codingSkeleton6478/stm32-motor-ecu/README.md

# stm32-motor-ecu

**STM32 두 개를 CAN으로 묶어, 한 보드가 보낸 목표 속도로 다른 보드가 모터를 돌리는 프로젝트입니다.**
엔코더로 속도를 재서 목표 속도를 유지하는 PI 제어, 두 보드 사이의 CAN 통신(체크섬과 alive counter로 메시지 오류를 검사하는 E2E 보호), 통신이 끊기거나 모터가 걸렸을 때 모터를 스스로 멈추는 기능을 직접 만들고, 일부러 고장을 내는 시험 7건으로 확인했습니다.

> **0 → 35 rpm 0.13 s 상승 · 오버슈트 0.9%** · **CAN 500 kbps, 0x200 프레임 208개 누락 0** · **통신 끊김 107 ms 만에 안전 정지** · **고장 주입 시험 7건 모두 통과**

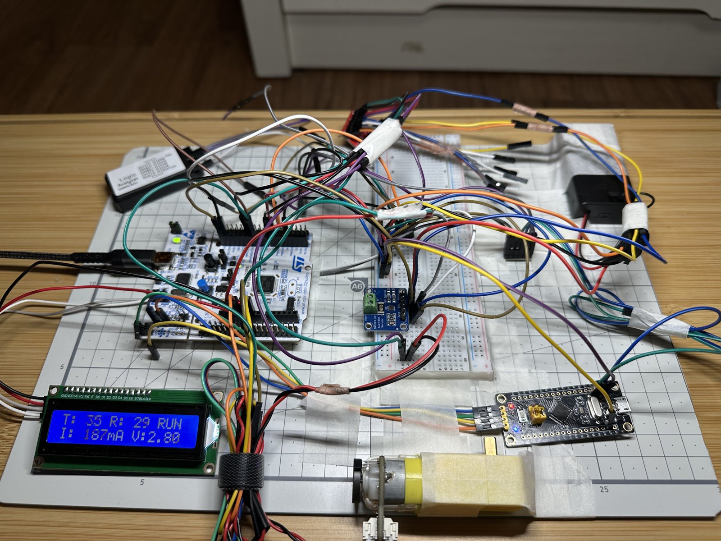
[picture p1: docs/images/hardware_setup.jpg]
실제 하드웨어 구성


*실제 동작 중인 하드웨어입니다. 왼쪽 NUCLEO-F103RB(모터 ECU), 오른쪽 아래 STM32F103C8T6 소형 보드(명령 ECU), 가운데 INA219 전류 센서, 아래 엔코더 기어드 모터, 왼쪽 아래 LCD에 목표 35 rpm · RUN 상태 · 전류 187 mA가 표시되고 있습니다.*

## 시스템 구성도

시스템 구성도

*draw.io로 그린 구성도입니다. 검은 화살표는 신호, 빨간 선은 모터 전원 경로, 굵은 선은 CAN 버스입니다. `docs/images/system_diagram.drawio.svg` 파일을 draw.io에서 열면 바로 수정할 수 있습니다.*

## 프로젝트 목적

STM32로 **모터를 직접 돌려 보고, 두 보드끼리 CAN 통신을 해 보는 것**을 배우고 싶어서 시작한 프로젝트입니다. 예제 코드를 그대로 돌리는 데서 끝내지 않고, 부품을 직접 고르고 배선하고, 실제로 잘 동작하는지 로직 분석기로 재 보는 것까지 해 보는 것을 목표로 했습니다.

이 프로젝트로 배우고 싶었던 것은 다음 세 가지입니다.

1. **모터 제어:** PWM으로 모터 속도를 바꾸고, 엔코더로 실제 속도를 읽어서 원하는 속도를 유지하도록(PI 제어) 만드는 방법
2. **CAN 통신:** 한 보드가 목표 속도를 보내고, 다른 보드가 받아서 모터를 돌린 뒤 현재 상태를 다시 보내는 2노드 통신
3. **문제 상황 대응:** 통신이 끊기거나 모터가 걸려 멈추는 상황을 알아채고 모터를 안전하게 세우는 방법

이 목적에 맞춰 아래 부품을 구매했습니다.

| 목적 | 부품 | 용도 |
|---|---|---|
| 모터 제어 보드 | NUCLEO-F103RB | 디버거가 내장돼 있어 바로 개발하고 디버깅할 수 있습니다 |
| 명령 보드 | STM32F103C8T6 소형 보드 | CAN 통신 상대가 될 두 번째 보드입니다 |
| CAN 통신 | SN65HVD230 트랜시버 × 2 | STM32의 CAN 신호를 실제 CAN 버스 신호로 바꿔 줍니다 |
| 모터 구동 | TB6612FNG 모터 드라이버 | MCU 신호로 모터에 큰 전류를 흘려 줍니다 |
| 모터 | FIT0450 엔코더 기어드 모터 | 엔코더가 달려 있어 실제 속도를 잴 수 있습니다 |
| 전류 측정 | INA219 전류 센서 | 모터가 걸렸을 때(과전류) 알아채는 데 씁니다 |
| 표시 | 1602 I2C LCD | 목표 속도, 실제 속도, 상태를 PC 없이 보여 줍니다 |
| 속도 입력 | 가변저항 모듈 | 손으로 목표 속도를 넣으려고 샀으나 파손되어 쓰지 못했습니다 |
| 측정 | USB 로직 분석기 | PWM, CAN 신호, 반응 시간을 직접 재 봅니다 |

### 왜 보드 두 개를 CAN으로 나눴나요

보드 한 개로도 모터는 돌릴 수 있습니다. 그래도 일부러 **명령하는 보드**와 **모터를 돌리는 보드**를 나누고 CAN으로 연결했습니다. 실제 자동차가 이렇게 동작하기 때문입니다. 자동차에서는 운전자의 페달 입력을 읽는 제어기와 실제로 모터나 엔진을 돌리는 제어기가 따로 있고, 둘이 CAN 버스로 명령과 상태를 주고받습니다.

이 구조를 작게 따라 하기 위해 역할을 이렇게 나눴습니다.

| 보드 | 역할 | 보내는 메시지 |
|---|---|---|
| 소형 보드 (명령 보드) | 사용자 대신 목표 속도를 정해서 보냅니다. 지금은 0 → 20 → 35 → 20 rpm 순서를 자동으로 반복합니다 | 0x100 목표 속도 (10 ms마다) |
| NUCLEO (모터 제어 보드) | 받은 목표 속도에 맞춰 엔코더와 PI 제어로 모터를 돌립니다 | 0x200 실제 속도 · 전류 · 상태 (20 ms마다) |

원래는 소형 보드에 가변저항을 달아, 자동차 가속 페달처럼 손잡이를 돌리면 CAN 너머의 모터 속도가 따라 올라가게 만들 계획이었습니다. 진행 중에 가변저항 모듈이 파손되어, 대신 정해진 속도 순서를 자동으로 보내는 방식으로 완성했습니다. 이 방식은 시험할 때마다 같은 조건을 만들 수 있어 측정을 비교하기에는 오히려 편했습니다.

보드를 나누면 한 보드에서는 생기지 않는 문제가 생깁니다. **통신선이 끊기거나 메시지가 깨지면 모터 제어 보드는 어떻게 해야 할까?** 하는 문제입니다. 명령이 끊겼는데 모터가 마지막 속도로 계속 돌면 위험하기 때문에, 모터 제어 보드는 정상 메시지가 100 ms 동안 오지 않으면 스스로 모터를 멈추게 했습니다. 실제로 CANH 선을 뽑아 시험했을 때 약 107 ms 만에 모터가 멈췄습니다.

또 메시지마다 **alive counter(순번 0~15)와 체크섬**을 넣어서(E2E 보호), 같은 메시지가 반복되거나 내용이 깨진 경우도 알아챌 수 있게 했습니다.

## 보드 구성

모든 수치는 직접 측정한 값입니다(근거: [`docs/measurements.md`](docs/measurements.md), [`docs/test_report.md`](docs/test_report.md)).

| 노드 | 보드 | 역할 |
|---|---|---|
| 모터 ECU | NUCLEO-F103RB | 엔코더 PI 속도 제어, 전류 감시, 고장 판단·안전 상태, IWDG |
| 명령 ECU | STM32F103C8T6 소형 보드 | 목표 속도 명령(0x100) 송신, 상태(0x200) 수신·LED 표시 |

## 핀 맵 (NUCLEO-F103RB)

| 기능 | MCU 핀 | 연결 |
|---|---|---|
| 모터 PWM 20 kHz | PA6 (TIM3_CH1) | TB6612 PWMA |
| 모터 방향 | PA8 / PA9 | TB6612 AIN1 / AIN2 |
| 드라이버 enable (안전 차단) | PB5 | TB6612 STBY |
| 엔코더 A / B (5 V, FT 핀) | PB6 / PB7 (TIM4 엔코더 모드) | FIT0450 엔코더 |
| I2C SCL / SDA (FT 핀) | PB8 / PB9 (I2C1 리맵) | INA219, LCD(PCF8574) |
| CAN RX / TX | PA11 / PA12 | SN65HVD230 CRX / CTX |
| 디버그 타이밍 | PB0 | 로직 분석기 |
| UART | PA2 / PA3 (USART2), PB10 (USART3 미러) | PC 로그 |

## CAN 메시지

| ID | 방향 | 주기 | 내용 |
|---|---|---|---|
| 0x100 CMD | 명령 ECU → 모터 ECU | 10 ms | B0–1 목표 rpm (uint16 LE) · B2 alive counter(순번) 0~15 · B3 체크섬 = (B0 ^ B1 ^ B2) ^ 0xFF |
| 0x200 STATUS | 모터 ECU → 명령 ECU | 20 ms | B0–1 실제 rpm (int16) · B2–3 전류 mA · B4 상태(0 STOP, 1 RUN, 2 FAULT) · B5 고장 코드 비트 |

비트 타이밍은 500 kbps, 샘플 포인트 87.5%(Nucleo) / 88.9%(소형 보드)입니다. 0x200 주기는 실측 19.99~20.20 ms이고, 4.15 s 동안 208개 중 누락은 0개였습니다.

## 속도 제어 결과 (SR-01)

PI(Kp 50, Ki 300, 10 ms 주기, 조건부 적분 anti-windup), 0 → 35 rpm 스텝, 무부하, AA×2 조건입니다.

| 상승시간(10→90%) | 오버슈트 | 정상상태 오차 | ±2% 정착 | 제어 ISR 실행 시간 |
|---|---|---|---|---|
| 0.13 s | 0.3 rpm (0.9%) | ±0.2 rpm | 0.62 s | 약 24 µs (10 ms 중 0.24%) |

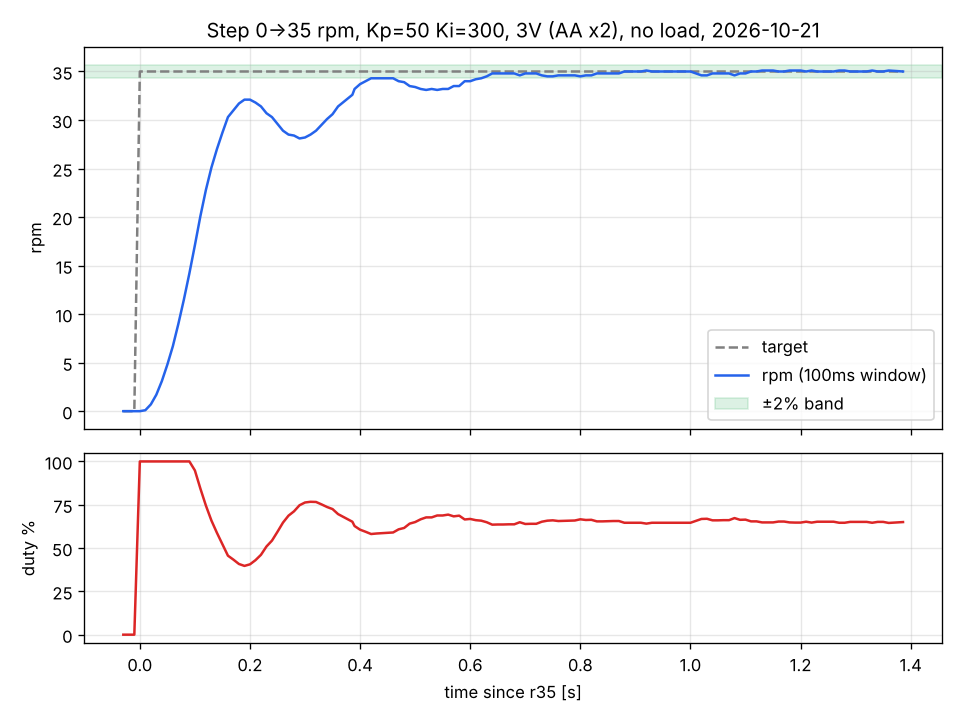
[picture p2: docs/captures/day06_step_kp50_ki300.png]
스텝 응답


제어 루프를 TIM2 ISR에서 돌리는 이유를 실험으로 확인했습니다. LCD I2C 블로킹 중 main loop에서 실행하면 제어 주기가 28.6 ms(가끔 57.3 ms)로 늘어나 rpm이 22.5~45.6으로 진동했고, ISR에서 실행하면 주기 10.026~10.029 ms로 35 rpm을 유지했습니다.

## 고장 감지와 안전 상태

| 요구사항 | 감지 조건 | 동작 |
|---|---|---|
| SR-02 | 유효 0x100이 100 ms 없음 | STBY Low + 듀티 0, 고장 코드 래치 |
| SR-03 | 체크섬·alive 오류 3회 연속 | 〃 |
| SR-04 | 전류 > 380 mA가 200 ms 지속 | 〃 |
| SR-05 | 듀티 > 40%인데 300 ms 동안 카운트 변화 < 10 | 〃 |
| SR-06 | main loop 멈춤 (IWDG 약 100 ms) | 칩 리셋, 부팅 시 원인 출력 |
| SR-07 | (복귀 조건) 감지 중인 고장 없음 + 목표 0 | FAULT → STOP |
| SR-08 | INA219 읽기 실패 200 ms 지속 | STBY Low + 듀티 0 |

상세 내용은 [`docs/requirements.md`](docs/requirements.md)에 있습니다.

## 고장 주입 시험 결과

| ID | 주입 | 결과 |
|---|---|---|
| FI-01 | CANH 선 분리 | 107.3 ms에 정지 |
| FI-02 | 명령 ECU 리셋 | 104.7 ms에 정지 |
| FI-03 | 체크섬 오염 | 첫 오염 프레임 후 28.6 ms에 정지 |
| FI-04 | 바퀴를 잡아 스톨 | 과전류로 약 200 ms에 정지 |
| FI-05 | 엔코더 전원 분리 | 약 570 ms에 정지 |
| FI-06 | main 무한 루프 | 워치독 리셋, `reset by watchdog` 출력 |
| FI-07 | 고장 중 통신 복구 | 목표 0 전까지 재가동 안 함 |

측정은 로직 분석기 12 MHz로 CAN(CRX)과 STBY를 동시에 캡처해, 마지막 유효 프레임부터 STBY 하강까지의 간격을 쟀습니다. 상세 내용과 시험 중 발견한 문제(과전류 임계값 600 → 380 mA 재설정 등)는 [`docs/test_report.md`](docs/test_report.md)에 있습니다.

## 신호 캡처

| 대상 | 파일 |
|---|---|
| CAN 루프백 (0x123) | [`docs/captures/day08_can_loopback.png`](docs/captures/day08_can_loopback.png) |
| CAN 2노드 0x100 디코딩 | [`docs/captures/day09_can_0x100.png`](docs/captures/day09_can_0x100.png) |
| CAN 2노드 0x100/0x200 | [`docs/captures/day09_can_2node.png`](docs/captures/day09_can_2node.png) |
| 고장 주입 원본 (CAN 주석 + VCD) | `docs/captures/day10_fi0*.txt`, `.vcd` |

## 알려진 한계

- 모터 전원이 AA×2(약 3 V)라 사양(6 V)보다 낮습니다. 최고 속도는 약 58 rpm, 스톨 전류는 약 430 mA입니다. 전원을 바꾸면 과전류 기준값을 다시 정해야 합니다.
- 엔코더 고장 감지는 300 ms 고정 구간으로 판단해서 최대 약 600 ms가 걸립니다(구간을 겹쳐 가며 보는 방식으로 줄일 수 있습니다).
- 과전류 기준값과 스톨 전류의 차이가 약 50 mA로 작습니다.
- CAN 선이 끊긴 동안에는 모터 제어 보드가 고장 상태를 명령 보드에 알릴 수 없습니다.
- 워치독 리셋 시간과 전류 센서 읽기 실패 감지(SR-08)는 정밀하게 시험하지 않았습니다.
- 가변저항 모듈이 파손되어 손으로 목표 속도를 바꾸는 입력은 없습니다. 목표 속도는 명령 보드의 자동 순서로만 정해집니다.

## 저장소 구조

```
stm32-motor-ecu/
├── nucleo_motor_ecu/     # 모터 ECU (CubeMX + CMake)
├── bluepill_cmd_ecu/     # 명령 ECU (CubeMX + CMake)
└── docs/
    ├── measurements.md   # 측정값 (모든 수치의 근거)
    ├── requirements.md   # 안전 요구사항 SR-01~08
    ├── test_report.md    # 고장 주입 시험 FI-01~07
    ├── images/           # 하드웨어 사진, 시스템 구성도(draw.io)
    └── captures/         # 로직 분석기 캡처, 그래프
```

## 개발 환경

STM32CubeMX, VS Code + CMake(arm-none-eabi-gcc), STM32CubeProgrammer CLI, PulseView(sigrok), C(HAL)을 사용했습니다.
