codingSkeleton6478/stm32-motor-ecu/docs/requirements.md

# 안전 요구사항 (SR) 과 검증 추적표

모터 ECU(NUCLEO-F103RB)의 안전 관련 요구사항이다. 각 요구사항은 코드 주석(`/* SR-xx */`)과 시험 ID(FI-xx)로 추적된다.
수치는 `docs/measurements.md`의 실측값만 사용한다.

## 1. 요구사항

| ID | 요구사항 | 근거 (설계 값을 정한 이유) | 구현 위치 | 검증 |
|---|---|---|---|---|
| SR-01 | 모터 ECU는 목표 RPM을 정상상태 오차 ±1 rpm 안에서 추종해야 한다. | Day 6 스텝 응답 실측 ±0.2 rpm에 여유를 둠 | `ctrl.c`, `pi.c` (TIM2 10 ms ISR) | Day 6 스텝 응답 0→35 rpm |
| SR-02 | 유효한 CMD(0x100) 프레임을 100 ms 동안 받지 못하면 110 ms 이내에 모터 출력을 차단(STBY Low, 듀티 0)해야 한다. | CMD 주기 10 ms의 10배. 판정이 10 ms 주기라 최대 지연 = 100 + 10 ms | `fault.c` `fault_step_10ms()` | FI-01, FI-02 |
| SR-03 | 체크섬 또는 alive counter가 틀린 프레임은 버리고, 3회 연속이면 FAULT로 전환해야 한다. | 단발 노이즈에는 반응하지 않고, 송신 측 고장은 약 30 ms 안에 잡음 | `can_if.c` 수신 콜백, `fault.c` | FI-03 |
| SR-04 | 모터 전류가 380 mA를 넘는 상태가 200 ms 지속되면 모터 출력을 차단해야 한다. | 정상 최대 315 mA(Day 7 손 부하)와 스톨 425~435 mA(Day 10, AA×2) 사이. 출발 순간 피크(최대 403 mA, 1샘플)는 200 ms 지속 조건으로 거름 | `fault.c` `check_current()` | FI-04 |
| SR-05 | 듀티가 40%를 넘는데 300 ms 동안 엔코더 카운트 변화가 10 미만이면 모터 출력을 차단해야 한다. | 듀티 40%에서 정상 회전은 300 ms에 약 400 카운트(Day 5 듀티-RPM 표, CPR 3840) | `fault.c` `check_encoder()` | FI-05 |
| SR-06 | 소프트웨어가 멈추면 워치독(IWDG)이 약 100 ms 안에 리셋해야 하고, 부팅 시 리셋 원인을 출력해야 한다. | LSI 40 kHz / 32 × 125 ≈ 100 ms (LSI 30~60 kHz 범위에서 67~133 ms). main loop 최장 블로킹(LCD 약 20 ms)보다 충분히 김 | `main.c` (refresh는 main loop에서만) | FI-06 |
| SR-07 | 고장 후에는 자동 재가동을 금지하고, 감지 중인 고장이 없고 목표가 0인 것을 확인한 뒤에만 STOP으로 복귀해야 한다. | 통신 복구 순간 마지막 목표로 갑자기 도는 것을 막음 | `fault.c` | FI-07 (FI-02, FI-04, FI-05에서도 관찰) |
| SR-08 | 전류 센서(INA219) 읽기 실패가 200 ms 지속되면 모터 출력을 차단해야 한다. | Day 7: I2C 실패 중 변수에 옛 값이 남아 정상처럼 보임 → 과전류 감시 불가 상태를 고장으로 봄 | `fault.c` `check_current()` | 미시험 (FI-08 예정) |

## 2. 고장 코드 (0x200 B5, 비트별)

| 비트 | 값 | 고장 | 요구사항 |
|---|---|---|---|
| 0 | 0x01 | CAN 타임아웃 | SR-02 |
| 1 | 0x02 | CAN E2E(체크섬·alive) 3회 연속 | SR-03 |
| 2 | 0x04 | 과전류 | SR-04 |
| 3 | 0x08 | 엔코더 고장 | SR-05 |
| 4 | 0x10 | 전류 센서 무효 | SR-08 |

고장 코드는 래치되며, SR-07 복귀 조건을 만족하면 0으로 지워진다.

## 3. 추적표 (요구사항 ↔ 시험)

| 요구사항 | FI-01 | FI-02 | FI-03 | FI-04 | FI-05 | FI-06 | FI-07 |
|---|---|---|---|---|---|---|---|
| SR-02 | ● | ● | ○ | | | | |
| SR-03 | | | ● | | | | |
| SR-04 | | | | ● | | | |
| SR-05 | | | | ○ | ● | | |
| SR-06 | | | | | | ● | |
| SR-07 | | ○ | | ○ | ○ | | ● |

● 주 검증, ○ 부수적으로 관찰
