codingSkeleton6478/stm32-motor-ecu/docs/captures/day08_can_loopback.png

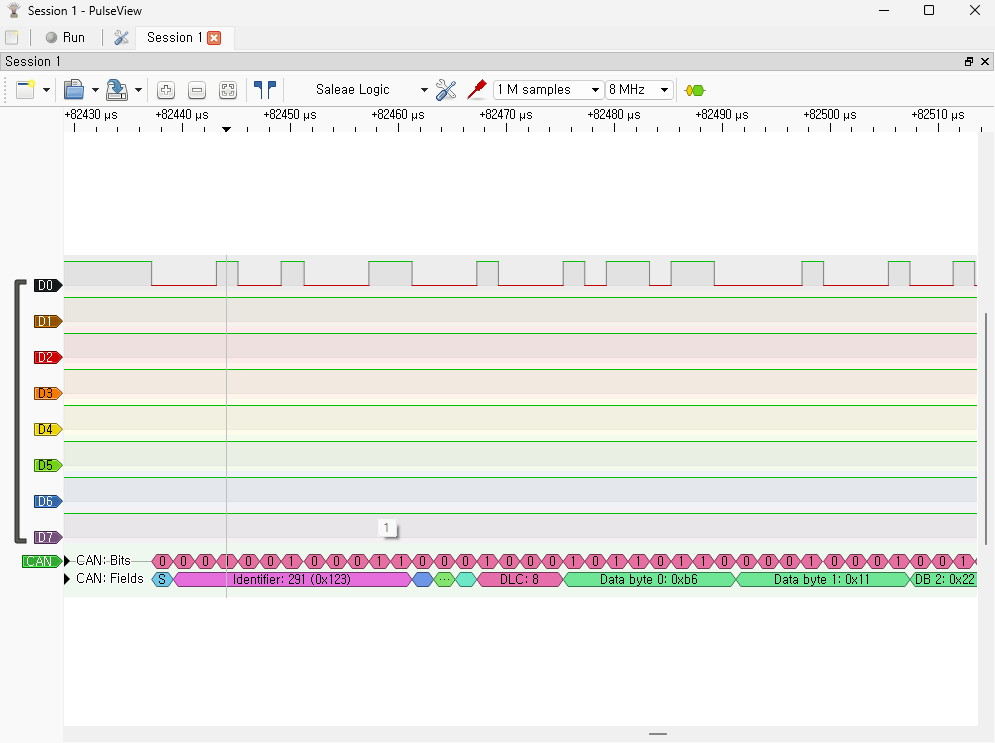
docs/captures/day08_can_loopback.png
