codingSkeleton6478/stm32-motor-ecu/docs/captures/day09_can_0x100.png

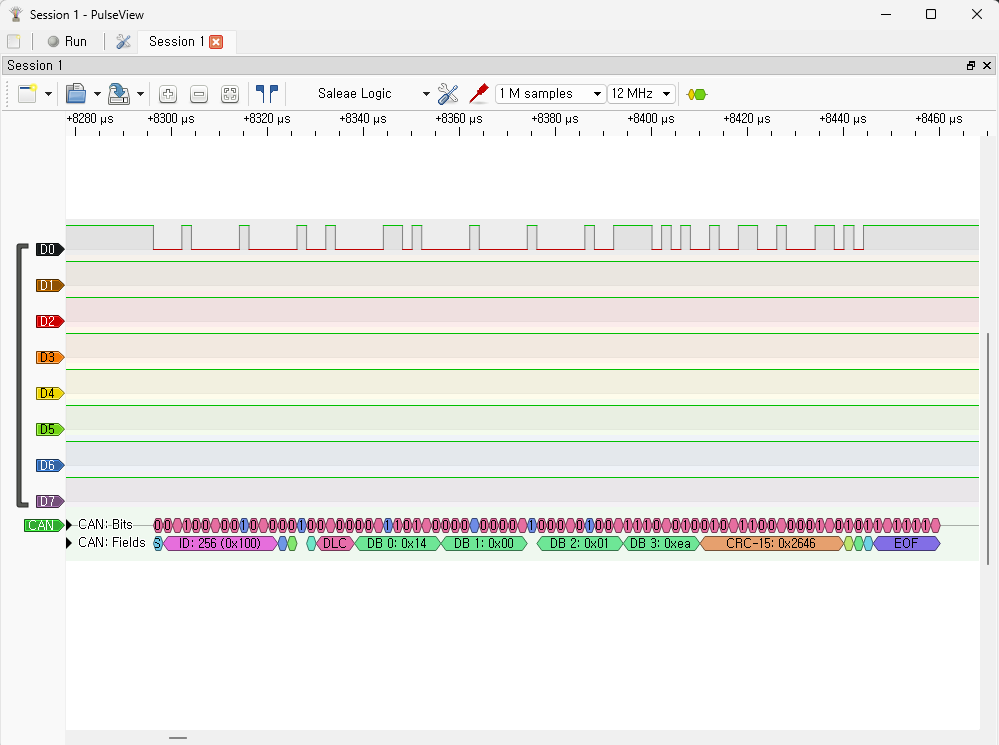
docs/captures/day09_can_0x100.png
