codingSkeleton6478/stm32-motor-ecu/docs/captures/day09_can_2node.png

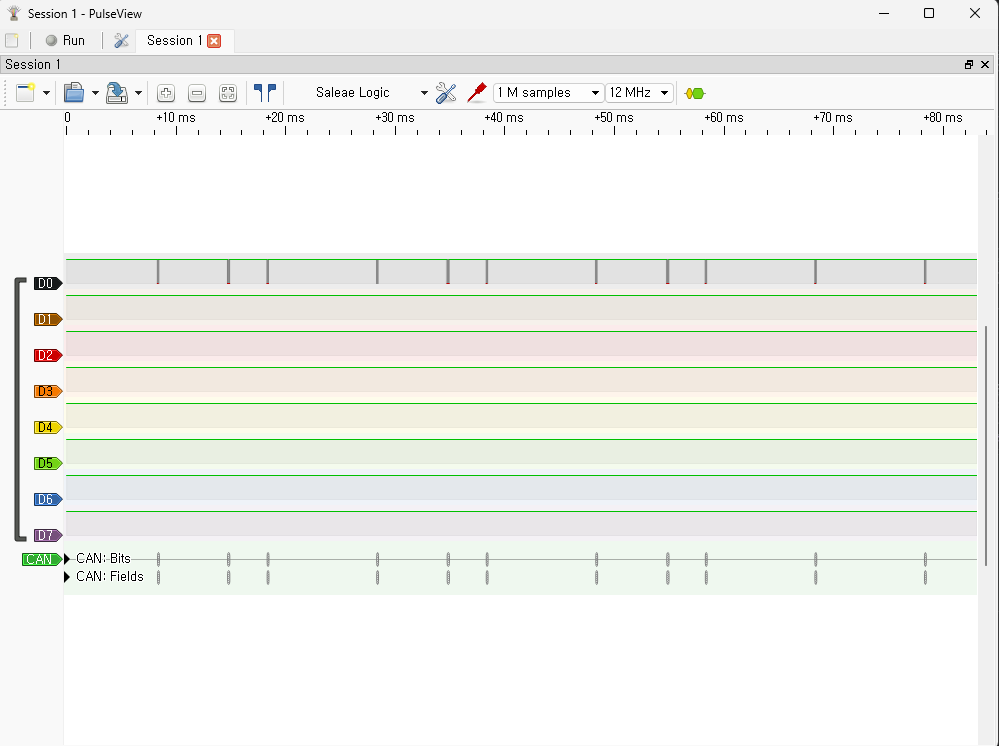
docs/captures/day09_can_2node.png
