codingSkeleton6478/stm32-motor-ecu/docs/measurements.md

# 측정값

이 프로젝트의 모든 수치는 아래 표의 실측값을 근거로 합니다. 측정 장비는 USB 로직 분석기(PulseView), INA219 전류 센서, UART 로그입니다. 모터 전원은 AA×2(약 3 V) 조건입니다.

| 항목 | 값 | 측정일 | 비고 |
|---|---|---|---|
| 클럭 SYSCLK / APB1 / APB2 | 64 / 32 / 64 MHz (설정값, HSI 8MHz/2×16) | 2026-10-17 | CubeMX 설정 기준. 실측 주기가 약 +0.2% 길다(아래 두 줄) |
| LED 주기 오차 | High/Low 폭 500.93~500.98 ms (설정 500 ms, 약 +0.19%) | 2026-10-17 | Day 1. PulseView 100kHz, D13(PA5) |
| 10ms 작업 주기 오차 / 실행 시간 | 10.021 ms (+0.21%), 지터 약 0.3 µs / 약 0.83 µs (±0.08 µs) | 2026-10-17 | Day 2. PB0(A3), PulseView 12MHz. CPU 부하 약 0.008~0.009% |
| ADC 노이즈: 가변저항, 필터 전/후 | 필터 전 2~3 count, 필터 후 0~1 count (최대−최소) | 2026-10-18 | Day 3. 손대지 않은 상태, 1초(10ms마다 1샘플, 100개) 구간. 출력 범위 raw 0~4095 확인 |
| TIM3 PWM(PA6) 주기 / High 폭 | 약 50 µs (20 kHz) / 약 15 µs (30%) | 2026-10-18 | Day 4. PulseView 24MHz 눈금 읽기. |
| 최소 구동 듀티 | 정회전 16~18% (d160~180), 역회전 16% (d-160, 1회 관찰) | 2026-10-19 | Day 4. AA×2(약 3V, 전압 미측정), 무부하, 정지 상태에서 출발, 눈으로 판정. 멈춘 위치에 따라 시작 값이 흔들림 |
| CPR (출력축 1바퀴, 4체배) | **3840** | 2026-10-20 | Day 5. d200으로 출력축 5바퀴(테이프 깃발로 셈) = 19453 카운트 → 3891/바퀴. 3840과 +1.3% 차이는 `s` 정지 타이밍 오차(약 0.07바퀴). 1920·7680은 배제. 사양(A상 960×4체배)과 일치 |
| 무부하 최고 RPM (3V, d1000) | 58.2 rpm (57.9~58.5) | 2026-10-20 | Day 5. 사양 3V 무부하 60 rpm 대비 약 97%. AA×2, 전압 미측정. 100 ms 창 RPM 중 튀는 값 제외 |
| 듀티-RPM (3V 무부하, 정회전) | d200 8.0 / d300 14.5 / d400 21.0 / d500 27.5 / d600 33.8 / d700 39.8 / d800 45.7 / d900 51.5 / d1000 58.2 rpm | 2026-10-20 | Day 5. 각 단계 약 3초, 정상상태 대표값. 거의 직선, 듀티 100당 약 6.3 rpm |
| Kp / Ki | 50 / 300 | 2026-10-21 | Day 6. Ki=0에서 Kp 100이 지속 진동(주기 약 0.2초, 100ms 로그 기준 추정) → 절반 50. Ki는 10~300 시험, 300에서도 오버슈트 0.3 rpm |
| 스텝 응답 0→35 rpm: 상승시간 / 오버슈트 / 정상상태 오차 | 0.13 s (10→90%) / 0.3 rpm (0.9%) / ±0.2 rpm, ±2% 정착 0.62 s | 2026-10-21 | Day 6. Kp 50 / Ki 300, AA×2(3V, 전압 미측정), 무부하, 10ms CSV 로그. 0.3초에 28 rpm으로 한 번 처짐(포화 중 조건부 적분 정지 때문). 그래프 `captures/day06_step_kp50_ki300.png` |
| 제어 루프 실행 시간 (TIM2 ISR, PB0) | 개루프 약 8.1 µs / PI 포함 약 24 µs | 2026-10-21 | Day 6. PulseView 12MHz 눈금 읽기. float PI 약 16 µs, 10ms 중 0.24%. |
| 손 부하 복원 | 뗀 뒤 약 0.5 s에 35 ±0.3 rpm 복귀, 뗀 직후 최고 40.0 rpm | 2026-10-21 | Day 6. 손가락 부하라 힘이 일정하지 않음 → 정성 결과로만 사용. 그래프 `captures/day06_load_kp50_ki300.png` |
| 제어 루프 지터: ISR 실행(A) vs main 실행(B) | A: 10.026~10.029 ms (3 µs) / B: 10.027 ms 기본, LCD 갱신 때 28.6 ms, 가끔 57.3 ms | 2026-11-07 | Day 7. r35, LCD 200ms 갱신(I2C 블로킹 약 18 ms) 중 PB0 주기. 두 경우 모두 `t10=93`. B는 rpm 22.5~45.6, 전류 0~400 mA로 200 ms마다 출렁임, A는 rpm 35 유지 |
| 건전지 전압 (AA×2, INA219 버스 전압) | 정지 3.18 V / r35 약 2.95~3.01 V / d1000 약 2.81~2.88 V / 출발 순간 최저 2.52 V | 2026-11-05 | Day 7. 첫 전압 실측. Vin− 기준 |
| 전류 (INA219, 건전지 측, 3V 무부하) | r20 약 60~73 mA / r35 약 98~155 mA / d1000 약 231~282 mA (52 rpm) | 2026-11-05 | Day 7. 20 ms마다 읽은 단발 샘플이라 ±20% 출렁임(PWM·브러시). 범위로 기록 |
| 전류: 출발 순간 최대 | r20 266.5 mA / r35 426~462 mA / d1000 550.3 mA | 2026-11-05 | Day 7. 정지→출발 첫 샘플. 정상상태의 3~4배 → 과전류 판정에 지속 시간 조건 필요 |
| 전류: 손 부하 (r35 유지 중) | 약 203~315 mA (최대 314.9 mA), rpm 33.4~37.0 유지 | 2026-11-05 | Day 7. 손가락 부하라 힘이 일정하지 않음, 1~2초 |
| I2C 실패 → 자동 복구 | SDA 분리 중 `valid=0`, 초당 실패 약 30회·리셋 약 10회. 재연결 후 RESET 없이 복구 | 2026-11-05 | Day 7. 연속 3회 실패 시 SWRST + 재초기화 |
| 스톨 전류 (AA×2, r35 중 바퀴 잡음) | 425~436 mA, 버스 전압 2.51~2.54 V | 2026-11-11 | Day 10 FI-04. INA219 100 ms 로그 + 0x200(20 ms). 사양 2.8 A는 6 V 기준, 건전지 처짐으로 3 V에서는 이 정도 |
| 과전류 임계값 | **380 mA, 200 ms 지속** | 2026-11-11 | Day 10. 정상 최대 315 mA(손 부하)와 스톨 425~436 mA 사이. 처음 600 mA(315×2)로는 스톨이 안 걸려 재설정. 적용 후 출발 순간 403 mA 1샘플에도 오검출 없음 |
| CAN 루프백 (500kbps) | 10초 tx=rx=100, miss 0 (93초 930개도 miss 0) | 2026-11-08 | Day 8. 0x123 DLC 8, 100ms 주기. Prescaler 4 / BS1 13 / BS2 2 / SJW 1, 샘플 포인트 87.5% |
| CAN 프레임 디코딩 | ID 0x123, DLC 8, DB0 카운터(캡처 시 0xB6), DB1~7 0x11~0x77, CRC 정상, 비트 폭 약 2 µs | 2026-11-08 | Day 8. PA12(CAN_TX), PulseView 8MHz. `captures/day08_can_loopback.png` |
| CAN 2노드 수신 (500kbps) | 0x100 초당 약 100개 수신, 체크섬 오류 0, alive 오류 3 | 2026-11-09 | Day 9. alive 오류는 CANH 분리·재연결 때 끊긴 프레임으로 번호가 건너뛴 것(연속 3회 미만이라 FAULT 아님) |
| CAN 메시지 주기 | 0x100 약 10 ms / 0x200 약 20 ms, 80 ms 캡처 중 0x200 1회 누락(약 40 ms 간격) | 2026-11-09 | Day 9. 트랜시버 A CRX, PulseView 12MHz 눈금 읽기. 0x200은 main loop에서 송신해 LCD I2C 블로킹 때 밀림. `captures/day09_can_2node.png` |
| 0x100 프레임 디코딩 | ID 0x100, DLC 4, DB0 0x14(20 rpm) DB1 0x00 DB2 0x01(alive) DB3 0xEA | 2026-11-09 | Day 9. 체크섬 (0x14^0x00^0x01)^0xFF = 0xEA 검산 일치. 0x200은 DLC 6 디코딩, ACK 정상 |
| CAN 목표 추종 | 목표 20 → 20.0 rpm, 35 → 35.0 rpm. 전류 20 rpm 약 59~72 mA, 35 rpm 약 136~146 mA | 2026-11-09 | Day 9. AA×2(정지 약 3.12 V), 무부하, Kp 50 / Ki 300 |
| CAN 타임아웃 → 안전 상태 (정성) | CANH 분리 시 즉시 정지, `st=2 fc=0x01`. 재연결 후 목표가 0이 될 때까지 FAULT 유지, 0 이후 STOP → RUN | 2026-11-09 | Day 9. 시간은 미측정 |
| 0x200 주기 (TIM2 ISR 송신 후) | 19.99~20.20 ms (평균 20.05), 4.15 s 동안 208개 누락 0 / 0x100 9.81~10.19 ms 417개 | 2026-11-10 | Day 10. PulseView 12 MHz, CAN 디코딩 결과 export 후 분석. 4 MHz에서는 디코더가 16/375 프레임 오독(가짜 ID) → CAN은 12 MHz로 디코딩 |
| CAN 타임아웃 → 모터 정지 시간 (FI-01 CANH 분리) | **107.3 ms** | 2026-11-11 | Day 10. 마지막 ACK된 0x100 EOF → STBY 하강, 12 MHz. 이론 101~110 ms(100 ms + 판정 주기 10 ms) |
| 명령 ECU 리셋 → 정지 (FI-02) | **104.7 ms** | 2026-11-11 | Day 10. 리셋 버튼 약 1.1 s. 재부팅 후 목표 0 확인 뒤 STBY 복귀 |
| E2E 오류 → 정지 (FI-03 체크섬 오염) | 첫 오염 프레임 → **28.6 ms** (3번째 오염 프레임 → 8.4 ms) | 2026-11-11 | Day 10. 소형 보드 BOOT1 캡(PB2)으로 체크섬 LSB 반전. 고장 코드 0x02 → 80 ms 뒤 0x03 |
| 과전류 → 정지 (FI-04 재시험) | 380 mA 초과 후 약 180~200 ms, `fc=0x04` | 2026-11-11 | Day 10. 전류 샘플 20 ms 간격이라 ±20 ms. 잡기 시작 → 정지 약 0.23 s |
| 엔코더 신호 소실 → 정지 (FI-05) | 약 570 ms, `fc=0x08` | 2026-11-11 | Day 10. 300 ms 고정 창 최악 약 600 ms. 그 사이 듀티 100% 무감시 회전(전류 150~230 mA) |
| 워치독 (FI-06) | 무한 루프 → 리셋, `reset by watchdog` 출력 | 2026-11-11 | Day 10. IWDG PR 32 / RL 125, 설계 약 100 ms(LSI 30~60 kHz면 67~133 ms). 시간은 정성 확인 |
| 고장 후 재가동 금지 (FI-07) | 통신 복구 후 약 3 s FAULT 유지, 목표 0에서 STOP | 2026-11-11 | Day 10. UART 로그 + LCD FLT |

그래프와 로직 분석기 캡처는 [`captures/`](captures/) 폴더에 있습니다.
