codingSkeleton6478/stm32-motor-ecu/docs/test_report.md

# 고장 주입 시험 결과 (FI-01 ~ FI-07)

- 시험일: 2026-11-10 ~ 11-11 (Day 10)
- 구성: 모터 ECU NUCLEO-F103RB ↔ CAN 500 kbps ↔ 명령 ECU STM32F103C8T6 소형 보드. 모터 전원 AA×2(정지 약 3.07 V), 무부하.
- 명령: 소형 보드 S-4 시퀀스 0 → 20 → 35 → 20 rpm (3초씩 반복)
- 측정: 로직 분석기 12 MHz. CH1 = 트랜시버 A CRX(PA11), CH2 = TB6612 STBY(PB5). PulseView CAN 디코더 주석 + VCD를 스크립트로 분석. 원본은 `docs/captures/day10_fi0*.txt/.vcd`.
- "정지 시점" = STBY 하강(TB6612 출력 Hi-Z).

## 결과표

| ID | 요구사항 | 주입 방법 | 기대 결과 | 측정 방법 | 측정 결과 | 판정 |
|---|---|---|---|---|---|---|
| FI-01 | SR-02 | 운전 중 CANH 선 분리 | 110 ms 이내 STBY Low | 마지막 ACK된 0x100 EOF → STBY 하강 | **107.3 ms** | 합격 |
| FI-02 | SR-02 | 소형 보드 리셋 버튼 약 1.1 s | 110 ms 이내 STBY Low | 위와 같음 | **104.7 ms** | 합격 |
| FI-03 | SR-03 | 소형 보드 BOOT1 캡을 +로(PB2 High) → 체크섬 1비트 반전 송신 | 3회 연속 오류 후 FAULT | 첫 오염 프레임 → STBY 하강, 0x200 고장 코드 | **28.6 ms** (3번째 오염 프레임 후 8.4 ms). 고장 코드 0x02 → 80 ms 뒤 0x03(타임아웃 추가) | 합격 |
| FI-04 | SR-04 | r35 운전 중 바퀴를 손으로 잡아 정지 | 과전류 FAULT, 모터 정지 | 0x200 전류(20 ms 간격) → STBY 하강, UART 로그 | 스톨 429~431 mA, 380 mA 초과 후 **약 180~200 ms**에 `fc=0x04`로 정지 | 합격 (재시험) |
| FI-05 | SR-05 | r35 운전 중 엔코더 VCC 선 분리 | 엔코더 FAULT, 모터 정지 | 0x200 rpm 소실 → STBY 하강 | 신호 소실 후 **약 570 ms**에 `fc=0x08`로 정지. 그 사이 듀티 100% 무감시 회전(전류 150~230 mA) | 합격 (한계 있음) |
| FI-06 | SR-06 | 시험 빌드(`FI06_TEST=1`)에서 B1 → main `while(1)` | IWDG 리셋, 재부팅 후 원인 출력 | UART 로그 | `FI-06: hang` 직후 재부팅, **`reset by watchdog`** 출력 | 합격 (시간은 정성) |
| FI-07 | SR-07 | 고장 후 목표 20 rpm인 동안 CANH 재연결 | 재가동하지 않음, 목표 0 후 STOP 복귀 | UART 로그 + LCD | 통신 복구(초당 약 100 프레임 수신) 후에도 약 3 s `st=2`·LCD `FLT` 유지, 목표 0에서 `st=0` | 합격 |

## 시험 중 발견과 조치

1. **FI-04 1차 불합격 → 임계값 재설정.** 처음 임계값 600 mA(정상 최대 315 mA × 2)로 시험했으나, AA×2 전원에서는 스톨 전류가 425~435 mA(전압 2.51 V로 처짐)라 과전류가 걸리지 않았다. 엔코더 고장(SR-05)이 rpm 0 후 481 ms에 대신 정지시켰다. 실측 정상 최대와 스톨 사이인 380 mA로 바꾸고, 출발 순간 403 mA 1샘플에도 오검출이 없음을 확인한 뒤 재시험해 과전류로 정지함을 확인했다.
2. **SR-02 기대값 수정.** 초기 요구사항 "100 ms 이내"는 10 ms 주기 판정 구조상 지킬 수 없다. 이론 범위 101~110 ms, 실측 104.7·107.3 ms → 요구사항을 "110 ms 이내"로 고쳤다.
3. **CAN 디코딩 샘플레이트.** 4 MHz(비트당 8샘플)에서 PulseView 디코더가 375개 중 16개 프레임을 잘못 읽어 가짜 ID(0x600, 0x30C 등)가 보였다. 12 MHz로 올리자 오독 0. 수신 칩은 같은 시간 체크섬 오류 0이었으므로 버스가 아니라 분석기 쪽 문제였다.

## 알려진 한계

- **엔코더 고장 감지가 최대 약 600 ms.** 300 ms 고정 창을 이어 붙이는 방식이라 고장이 창 시작 직후면 다음 창 끝에서 걸린다(FI-05 570 ms, FI-04 1차 481 ms). 최근 300 ms를 10 ms마다 다시 보는 슬라이딩 창으로 바꾸면 최대 약 310 ms로 줄일 수 있다.
- **과전류 임계값 여유가 작다.** 스톨(약 430 mA)과 임계값(380 mA)의 차이가 약 50 mA라, 건전지가 더 닳으면 스톨 전류가 임계값 아래로 내려갈 수 있다. 이때는 SR-05가 뒤를 받친다. 6 V 전원으로 바꾸면 다시 측정해 정해야 한다.
- **버스가 끊긴 동안 FAULT 상태를 알릴 수 없다.** CANH가 끊기면 Nucleo의 0x200이 ACK를 못 받아 자동 재전송을 반복하고, 메일박스에 남은 RUN 상태 프레임이 계속 나간다(FI-01 캡처).
- **SR-06 리셋 시간은 정밀 측정하지 않았다.** 설계값 약 100 ms(LSI 오차로 67~133 ms).
- **SR-08(전류 센서 무효)은 시험하지 않았다.** INA219 SDA 분리로 FI-08을 추가할 수 있다.
- 시험은 무부하·AA×2(약 3 V)에서만 했다.
