codingSkeleton6478/stm32-motor-ecu/nucleo_motor_ecu/Core/Src/main.c

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
/* Includes ------------------------------------------------------------------*/
#include "main.h"

/* USER CODE BEGIN Includes */
#include "stdio.h"
#include "stm32f1xx_hal_adc_ex.h"
#include <stdint.h>
#include <stdbool.h>
#include "motor.h"
#include "cmd.h"
#include "encoder.h"
#include "ctrl.h"
#include "stm32f1xx_hal_def.h"
#include "stm32f1xx_hal_gpio.h"
#include "stm32f1xx_hal_i2c.h"
#include "can_if.h"
#include "ina219.h"
#include "lcd.h"
#include "fault.h"
/* USER CODE END Includes */

/* USER CODE BEGIN PD */
#define TASK_10MS_PERIOD    (10U)
#define TASK_100MS_PERIOD  (100U)
#define TASK_1000MS_PERIOD (1000U)
#define LED_PIN_POS        (5U)       // PA5 = 5번 핀
#define LED_PIN_MASK       (1UL << LED_PIN_POS) // 0x0020 5번 비트만 1인 값
#define LED_CRL_SHIFT      (LED_PIN_POS * 4U)   //CRL에서 PA5 설정이 시작하는 비트 = 20 (핀당 4비트)
#define ADC_MAX_COUNT      (4095U) //12비트 ADC 최대값
#define ADC_MA_LEN         (16U) //이동평균에 쓰는 샘플 수 
#define ADC_MA_SHIFT       (4U) // 16 = 2^4 -> 나누기 대신 4칸 오른쪽 이동
/* Day 7 실험: 1 = 제어 루프를 TIM2 ISR에서 실행(원래 방식, A)
 *             0 = main loop의 10ms 태스크에서 실행(비교용, B)
 * 실험이 끝나면 반드시 1로 되돌린다 */
#define CTRL_IN_ISR        (1)
#define STATUS_DIV_10MS    (2U) //0x200 주기 20ms
#define FI06_TEST          (0)  //FI-06 시험용: 1 = B1 버튼 누르면 main을 일부러 멈춤. 시험 후 반드시 0

/* USER CODE END PD */

ADC_HandleTypeDef hadc1;
DMA_HandleTypeDef hdma_adc1;

CAN_HandleTypeDef hcan;

I2C_HandleTypeDef hi2c1;

IWDG_HandleTypeDef hiwdg;

TIM_HandleTypeDef htim2;
TIM_HandleTypeDef htim3;
TIM_HandleTypeDef htim4;

UART_HandleTypeDef huart2;
UART_HandleTypeDef huart3;

/* USER CODE BEGIN PV */
static volatile uint8_t g_btn_pressed = 0U;
static volatile uint32_t g_ms_tick = 0U;
static volatile uint32_t g_flag_10ms = 0U;
static volatile uint32_t g_flag_100ms = 0U;
static volatile uint32_t g_flag_1000ms = 0U;
static volatile uint16_t adc_buf[1];    // DMA가 여기에 최신 변환 값을 계속 덮어 씀(ISR/DMA와 main이 공유 -> volatile)
static volatile uint16_t g_ina_ma = 0U; /*main이 INA219로 읽은 전류(mA)
                                        TIM2 ISR이 0x200에 실어 보낸다. ISR과 main이 같이 쓰므로 volatile. 16비트 값*/
/* USER CODE END PV */

void SystemClock_Config(void);
static void MX_GPIO_Init(void);
static void MX_DMA_Init(void);
static void MX_USART2_UART_Init(void);
static void MX_TIM2_Init(void);
static void MX_USART3_UART_Init(void);
static void MX_ADC1_Init(void);
static void MX_TIM3_Init(void);
static void MX_TIM4_Init(void);
static void MX_I2C1_Init(void);
static void MX_CAN_Init(void);
static void MX_IWDG_Init(void);
/* USER CODE BEGIN 0 */
int __io_putchar(int ch)
{
  uint8_t c = (uint8_t)ch;        // int(4바이트) → 1바이트 글자로 안전하게 변환
  (void)HAL_UART_Transmit(&huart2, &c, 1U, HAL_MAX_DELAY);    // 기존: USART2 → ST-LINK → PC 시리얼 모니터
  (void)HAL_UART_Transmit(&huart3, &c, 1U, HAL_MAX_DELAY);    // 추가: USART3 → PB10(D6) → 로직 분석기
  return ch;       // printf 규칙: 보낸 글자를 돌려줌
}
void HAL_GPIO_EXTI_Callback(uint16_t GPIO_Pin)
{
  if (GPIO_Pin == B1_Pin)
  {
    g_btn_pressed = 1U;
  }
}
// LD2(PA5)를 HAL 없이 레지스터로 설정한다. 근거: RM0008 7.3.7, 9.2.1 
static void LedReg_Init(void)
{
  RCC->APB2ENR |= RCC_APB2ENR_IOPAEN;   //GPIOA 클럭 켜기, 꺼져 있으면 아래 쓰기가 전부 무시됨
  GPIOA->CRL  &= ~(0xFUL << LED_CRL_SHIFT);   //PA5의 4비트(23:20)를 먼저 0000으로 지우기
  /* &= 다음에 |=하는 이유는 CRL은 핀 8개의 설정이 한 레지스터에 같이 들어있다
     그래서 PA5칸만 지우고 -> 새 값을 넣어야 다른핀 설정이 안 망가진다. 이걸 Read modify wirte라고함.*/
  GPIOA-> CRL |= (0x2UL << LED_CRL_SHIFT);    //0010 쓰기: MODE=10(출력 2MHz), CNF=00(push-pull)
  GPIOA-> BRR = LED_PIN_MASK;   // 시작은 꺼진 상태로
}
// LD2를 레지스터로 토글한다. 근거: RM0008 9.2.4(ODR), 9.2.5(BSRR), 9.2.6
static void LedReg_Toggle(void)
{
  if((GPIOA->ODR & LED_PIN_MASK) != 0U)   // ODR = 지금 내보내는 값. 5번 비트가 1이면 켜져 있는 것
  {
    GPIOA->BRR = LED_PIN_MASK;
  }
  else {
  {
    GPIOA->BSRR = LED_PIN_MASK;
  }
  }
}
/* USER CODE END 0 */

/**
  * @brief  The application entry point.
  * @retval int
  */
int main(void)
{

  /* MCU Configuration--------------------------------------------------------*/

  /* Reset of all peripherals, Initializes the Flash interface and the Systick. */
  HAL_Init();

  /* Configure the system clock */
  SystemClock_Config();

  /* Initialize all configured peripherals */
  MX_GPIO_Init();
  MX_DMA_Init();
  MX_USART2_UART_Init();
  MX_TIM2_Init();
  MX_USART3_UART_Init();
  MX_ADC1_Init();
  MX_TIM3_Init();
  MX_TIM4_Init();
  MX_I2C1_Init();
  MX_CAN_Init();
  /* USER CODE BEGIN 2 */
  printf("CTRL_IN_ISR=%d\r\n", CTRL_IN_ISR);
    /* SR-06: 리셋 원인 확인. RCC->CSR의 플래그는 리셋돼도 남아 있다가 직접 지워야 사라진다 */
  if (__HAL_RCC_GET_FLAG(RCC_FLAG_IWDGRST) != 0U)
  {
    printf("reset by watchdog\r\n");      /* 지난번에 소프트웨어가 멈춰 IWDG가 리셋함 */
  }
  else if (__HAL_RCC_GET_FLAG(RCC_FLAG_PINRST) != 0U)
  {
    printf("reset by NRST pin\r\n");      /* 리셋 버튼, 또는 디버거가 건 리셋 */
  }
  else
  {
    /* 그 밖(전원 켬 등) */
  }
  __HAL_RCC_CLEAR_RESET_FLAGS();          /* RMVF 비트로 전부 지움 -> 다음 리셋 때 새 원인만 남음 */
  uint32_t blink_ms = 500U;
  uint32_t blink_acc = 0U;
  uint32_t last_btn = 0U;
  uint32_t tick_count = 0U;
  uint32_t run_10ms = 0U;
  uint32_t run_100ms = 0U;
  int16_t ina_i_x10 = 0;
  uint16_t ina_bus_mv = 0U;
  uint32_t ina_div = 0U;
  uint32_t lcd_div = 0U; //100ms 태스크를 2번 세서 200ms마다 LCD갱신
  char lcd_line[17]; //16글자 + 문자열 끝 표시 '\0' 1칸

  LedReg_Init();          // LED를 레지스터로 다시 설정(HAL 설정을 덮어씀)
  uint16_t ma_buf[ADC_MA_LEN] = {0U}; // 최근 16개 샘플 보관
  uint32_t ma_sum = 0U; //16개의 합
  uint32_t ma_idx = 0U; // 다음에 덮어쓸 칸
  uint16_t adc_raw = 0U; //필터 전 값
  uint16_t adc_avg = 0U; //필터 후 값
  uint16_t raw_min = ADC_MAX_COUNT, raw_max = 0U; //1초 동안의 필터 전 최소/최대
  uint16_t avg_min = ADC_MAX_COUNT, avg_max = 0U; //1초 동안의 필터 후 최소/최대

  if(HAL_ADCEx_Calibration_Start(&hadc1) != HAL_OK)  //F1 전용 자체 보정. 시작 전에 해야함
  {
    Error_Handler();
  }
  if(HAL_ADC_Start_DMA(&hadc1, (uint32_t *)adc_buf, 1U) != HAL_OK) // 변환 시작 + DMA가 adc_but[0]에 계속 저장
  {
    Error_Handler();
  }
   __HAL_DMA_DISABLE_IT(&hdma_adc1, (DMA_IT_TC | DMA_IT_HT));   // 완료·절반 완료 인터럽트만 끔. 전송 자체(DMA 복사)는 계속됨
  motor_init();
  motor_enable(true);
  encoder_init();
  ctrl_init();
  cmd_init();
  printf("Day6 start\r\n");
  printf("Day7 start\r\n");
  /*Day 7: I2C 버스 스캔. 응답(ACK)하는 7비트 주소를 출력한다 */
  {
    uint32_t found = 0U;
    for(uint16_t addr = 1U; addr < 128U; addr++)
    {
      /*HAL은 8비트 형식 주소를 받는다:7비트 주소를 한칸 왼쪽으로, bit0은 R/W자리*/
      if(HAL_I2C_IsDeviceReady(&hi2c1, (uint16_t)(addr << 1), 1U, 10U) == HAL_OK)
      {
        printf(" found 0x%02X\r\n", (unsigned)addr);
        found++;
      }
    }
    printf("I2C scan: %lu device(s)\r\n", (unsigned long)found);
  }
  {
    uint16_t cfg = 0U;
    HAL_StatusTypeDef st = ina219_init(&hi2c1, &cfg);
    printf("INA219 init=%d cfg=0x%04X\r\n",(int)st, (unsigned)cfg);
  }
    /* Day 7: LCD 초기화 + 시험 문구 */
  {
    HAL_StatusTypeDef st = lcd_init(&hi2c1);
    printf("LCD init=%d\r\n", (int)st);          /* 0이면 성공 */
    (void)lcd_set_cursor(0U, 0U);
    (void)lcd_print("Day7 LCD OK");
    (void)lcd_set_cursor(1U, 0U);
    (void)lcd_print("Motor ECU");
  }

  //Day 8: CAN 루프백 시작(필터 -> start -> 수신 인터럽트)
  printf("CAN init=%d\r\n", (int)can_if_init(&hcan)); //0이면 성공

  fault_init(); //제어 ISR시작전에 안전 상태로 초기화

  if (HAL_TIM_Base_Start_IT(&htim2) != HAL_OK)
  {
    Error_Handler();
  }
    __HAL_DBGMCU_FREEZE_IWDG();   /* 디버거가 CPU를 세우면 IWDG도 멈춤(브레이크포인트에서 리셋 방지) */
  MX_IWDG_Init();               /* 초기화가 다 끝난 뒤에 켠다. 한 번 켜면 끌 수 없음 */
  printf("IWDG on (~100ms)\r\n");
  /* USER CODE END 2 */

  /* Infinite loop */
  /* USER CODE BEGIN WHILE */
  while (1)
  {
    /* USER CODE END WHILE */

    /* USER CODE BEGIN 3 */
    HAL_IWDG_Refresh(&hiwdg);   /* SR-06: main loop가 한 바퀴 돌 때마다 카운터를 125로 되돌림 */
    cmd_poll();
    if(g_btn_pressed != 0U)
    {
      g_btn_pressed = 0U;
      uint32_t now = HAL_GetTick();
      if((now - last_btn) >= 50U)
      {
        last_btn = now;
        blink_ms = (blink_ms == 500U) ? 100U : 500U;
        printf("blink %lu ms\r\n", (unsigned long)blink_ms);
        #if (FI06_TEST != 0)
        printf("FI-06: hang\r\n");   /* 이 줄이 찍힌 뒤 main이 멈춘다 */
        while (1)
        {
          /* SR-06 시험: 여기서 HAL_IWDG_Refresh()가 더 이상 불리지 않음 -> 약 100ms 뒤 IWDG 리셋 */
        }
        #endif
      }
    }

    // 10ms 태스크: 다음 단계에서 PB0 타이밍 핀을 붙일 자리
    if(g_flag_10ms != 0U)
    {
      g_flag_10ms = 0U;     // 깃발을 먼저 내림
#if (CTRL_IN_ISR == 0)
      /* B: main이 깃발을 확인했을 때야 실행된다.
       *    main이 LCD 갱신(I2C 블로킹 약 20ms) 중이면 그게 끝날 때까지 늦어지고,
       *    그 사이 깃발이 두 번 서도 한 번만 실행된다(한 주기 놓침) */
      HAL_GPIO_WritePin(DBG_TIMING_GPIO_Port, DBG_TIMING_Pin, GPIO_PIN_SET);
      ctrl_step_10ms();
      HAL_GPIO_WritePin(DBG_TIMING_GPIO_Port, DBG_TIMING_Pin, GPIO_PIN_RESET);
#endif      
      run_10ms++;           // 셀자 작업(지금은 횟수 세기뿐, 6일차에 PI 제어가 들어옴)
      adc_raw = adc_buf[0]; // DMA가 채워둔 최신 값을 한 번 집어 옴
      ma_sum -= ma_buf[ma_idx]; // 가장 오래된 값을 합에서 빼고
      ma_buf[ma_idx] = adc_raw; //그 자리에 새 값을 넣고
      ma_sum += adc_raw; //합에 더함
      ma_idx = (ma_idx + 1U) % ADC_MA_LEN; //다음칸 (15다음은0)
      adc_avg = (uint16_t)(ma_sum >> ADC_MA_SHIFT); // 합/16 = 평균
      if(adc_raw < raw_min) {raw_min = adc_raw;} //노이즈 측정: 최소/최대 갱신
      if(adc_raw > raw_max) {raw_max = adc_raw;}
      if(adc_avg < avg_min) {avg_min = adc_avg;}
      if(adc_avg > avg_max) {avg_max = adc_avg;}
      if (cmd_log_on())
      {
        printf("%lu,%d,%ld,%d\r\n", (unsigned long)g_ms_tick,
               (int)(ctrl_get_target_rpm() * 10.0f),
               (long)ctrl_get_rpm_x10(), (int)ctrl_get_duty());
      }

      if(++ina_div >= 2U) /* 10ms x 2 = 20ms마다*/
      {
        ina_div = 0U;
        (void)ina219_read(&ina_i_x10, &ina_bus_mv);
        /*0x200 송신은 TIM2 ISR로 옮김. 여기서는 전류 값만 넘긴다(0.1mA 단위 -> mA, 음수는 0)*/
        g_ina_ma = (ina_i_x10 > 0) ? (uint16_t)(ina_i_x10 / 10) : 0U;
        fault_set_current(g_ina_ma, ina219_is_valid()); //SR-04/08: 판정은 ISR이 하고 main은 값만 넘김
      }

    }

    // 100ms 태스크: LED 깜빡임
    if(g_flag_100ms != 0U)
    {
      g_flag_100ms= 0U;
      run_100ms++;
      printf("rpm_x10=%ld I_x10=%d mA V=%u mV\r\n", (long)encoder_get_rpm_x10(),
      (int)ina_i_x10, (unsigned)ina_bus_mv);
      //printf("rpm_x10=%ld\r\n", (long)encoder_get_rpm_x10());
      //printf("tot=%ld d=%d\r\n", (long)encoder_get_total(), (int)encoder_get_delta());
      //printf("adc raw=%4u avg=%4u pct=%3u%%\r\n", (unsigned)adc_raw,(unsigned)adc_avg, (unsigned)(((uint32_t)adc_avg*100U) / ADC_MAX_COUNT)); //0~4095 -> 0~100% 
      blink_acc += TASK_100MS_PERIOD;   //100ms 흘렀음
      if(blink_acc >= blink_ms)         //정한 간격만큼 쌓이면
      {
        blink_acc = 0U;                    //누적 시간 초기화
        LedReg_Toggle();
        /*HAL_GPIO_TogglePin(LD2_GPIO_Port, LD2_Pin); //LED 토글, 레지스터로 LED 토글을 위해 잠시 비활성화*/
      }
      /* LCD 갱신 (200ms마다). I2C 블로킹 약 20ms라 ISR이 아닌 main loop에서 한다 */
      if (++lcd_div >= 2U)
      {
        lcd_div = 0U;
        int32_t rpm = (int32_t)ctrl_get_rpm_x10() / 10;        /* 0.1rpm 단위 → rpm 정수 */
        int32_t tgt = (int32_t)ctrl_get_target_rpm();          /* 목표 rpm */
        static const char *const k_st[] = {"STP", "RUN", "FLT"};  /* ecu_state_t 순서와 같게 */
        ecu_state_t st = fault_get_state();
        /* LCD 3칸에 맞게 0~999로 제한: 이상값이 줄을 밀어내지 않고, 컴파일러도 길이를 확정할 수 있다 */
        if (rpm < 0) { rpm = 0; } else if (rpm > 999) { rpm = 999; }
        if (tgt < 0) { tgt = 0; } else if (tgt > 999) { tgt = 999; }
        (void)snprintf(lcd_line, sizeof(lcd_line), "T:%3ld R:%3ld %s", (long)tgt, (long)rpm, k_st[(uint32_t)st]);
        (void)lcd_print_line(0U, lcd_line);

        if (ina219_is_valid() != 0U)
        {
          /* LCD 칸 수에 맞게 범위를 먼저 자른다.
          전류 -999~9999mA(최대 4글자), 전압 정수부 0~9V(1글자) -> "I:9999mA V:9.99" = 15글자 + '\0' = 16칸 <= 17칸 */
          int32_t  ma   = (int32_t)ina_i_x10 / 10;          /* 0.1mA 단위 → mA */
          uint32_t v_i  = (uint32_t)ina_bus_mv / 1000U;     /* 정수 V */
          uint32_t v_f  = ((uint32_t)ina_bus_mv % 1000U) / 10U;  /* 소수 둘째 자리 (0~99) */
          if (ma < -999) { ma = -999; } else if (ma > 9999) { ma = 9999; }
          if (v_i > 9U) { v_i = 9U; }   /* 우리 전원은 약 3V. 9V 넘는 값은 이상값이라 표시만 제한 */
          (void)snprintf(lcd_line, sizeof(lcd_line), "I:%4ldmA V:%lu.%02lu",
                         (long)ma, (unsigned long)v_i, (unsigned long)v_f);
        }
        else
        {
          /* 센서 값이 믿을 수 없으면 옛 숫자를 보여 주지 않는다 */
          (void)snprintf(lcd_line, sizeof(lcd_line), "I:----mA V:-.--");
        }
        (void)lcd_print_line(1U, lcd_line);
      }
    }

    // 1000ms 태스크: 상태 로그 (printf처럼 느린 일은 느린 태스크에)
    if(g_flag_1000ms !=0U)
    {
      g_flag_1000ms =0U;
      printf("tick %lu time2-%lu hal-%lu t10=%lu t100=%lu\r\n",
              (unsigned long)tick_count, (unsigned long)g_ms_tick,
              (unsigned long)HAL_GetTick(),
              (unsigned long)run_10ms, (unsigned long)run_100ms);
      printf("noise raw=%u avg=%u\r\n", (unsigned)(raw_max - raw_min), (unsigned)(avg_max - avg_min));
      printf("ina vaild= %u err=%lu rec=%lu\r\n", (unsigned)ina219_is_valid(),
              (unsigned long)ina219_get_err_count(),
              (unsigned long)ina219_get_recover_count());
      {
        can_if_stats_t cs;
        can_if_get_stats(&cs);
        /* age = 마지막 유효 프레임 이후 경과 ms. 정상이면 0~10, 선이 빠지면 계속 커진다 */
        printf("can ok=%lu cs=%lu alive=%lu dlc=%lu cons=%u rpm=%u a=%u age=%lu\r\n",
               (unsigned long)cs.rx_ok, (unsigned long)cs.err_checksum,
               (unsigned long)cs.err_alive, (unsigned long)cs.err_dlc,
               (unsigned)cs.consec_err, (unsigned)cs.last_rpm, (unsigned)cs.last_alive,
               (unsigned long)(HAL_GetTick() - cs.last_ok_ms));
        printf("ecu st=%u fc=0x%02X\r\n", (unsigned)fault_get_state(), (unsigned)fault_get_code());
      }
      
      raw_min = ADC_MAX_COUNT; raw_max = 0U; //다음 1초를 다시 잼
      avg_min = ADC_MAX_COUNT; avg_max = 0U; 
      tick_count++;
      run_10ms = 0U;        //다음 1초를 다시 셈
      run_100ms = 0U;
    }
  }
  /* USER CODE END 3 */
}

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
/* USER CODE BEGIN 4 */
void HAL_TIM_PeriodElapsedCallback(TIM_HandleTypeDef *htim)
{
  if (htim->Instance == TIM2)
  {
    g_ms_tick++;
    if ((g_ms_tick % TASK_10MS_PERIOD) == 0U)
    {
      g_flag_10ms = 1U; //main에게 10ms가 지났다는 알림을 보내는 코드
      /* DAY6이전에 사용한 HAL Timer 코드
      HAL_GPIO_WritePin(DBG_TIMING_GPIO_Port, DBG_TIMING_Pin, GPIO_PIN_SET);   // PB0 High: 제어 시작 
      ctrl_step_10ms();  // 엔코더 -> PI -> PWM 
      HAL_GPIO_WritePin(DBG_TIMING_GPIO_Port, DBG_TIMING_Pin, GPIO_PIN_RESET);  PB0 Low: 제어 끝  */
      //
#if (CTRL_IN_ISR != 0)
      /* A: ISR 안에서 바로 실행. main이 무엇을 하든(LCD 블로킹 중이어도) 10ms마다 끼어들어 실행된다 */
      HAL_GPIO_WritePin(DBG_TIMING_GPIO_Port, DBG_TIMING_Pin, GPIO_PIN_SET);   /* PB0 High: 제어 시작 */
      fault_step_10ms();         /* 통신 상태 판단 -> 목표값 적용 또는 안전 상태 */
      ctrl_step_10ms();          /* 엔코더 -> PI -> PWM */
      {
        static uint8_t s_status_div = 0U; //static:함수가 끝나도 값이 남아 있는 카운터
        if(++s_status_div >= STATUS_DIV_10MS)
        {
          s_status_div = 0U;
          //송신 메일 박스에 넣기만 하고 바로 돌아온다(전송 완료를 기다리지 않음) -> ISR이 길어지지 않음.
          //메일 박스 3개가 다 차있으면(상대 없음) HAL_BUSY로 그냥 건너 뛴다.
          (void)can_if_send_status((uint16_t)(ctrl_get_rpm_x10() / 10),
                                    g_ina_ma,
                                    (uint8_t)fault_get_state(),
                                    fault_get_code());
        }
      }
      HAL_GPIO_WritePin(DBG_TIMING_GPIO_Port, DBG_TIMING_Pin, GPIO_PIN_RESET); /* PB0 Low: 제어 끝 */
#endif
    }
    if ((g_ms_tick % TASK_100MS_PERIOD) == 0U)
    {
      g_flag_100ms = 1U;
    }
    if ((g_ms_tick % TASK_1000MS_PERIOD) == 0U)
    {
      g_flag_1000ms = 1U;
    }
  }
}
/* USER CODE END 4 */
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
