codingSkeleton6478/stm32-motor-ecu/(commit log)

2026-10-16 day01: 개발환경 구성, LED 깜빡이기
2026-10-16 day01: UART printf, B1 EXTI 버튼으로 깜빡임 주기 전환
2026-10-17 Day 2: TIM2 1ms 스케줄러, PB0 타이밍 측정, 레지스터 LED, UART3 printf 미러
2026-10-18 Day 3완료(ADC+DMA, 이동평균, 노이즈 측정) + Day4 일부(TIM3 PWM 20kHz, motor.c/h, TB6612배선)
2026-10-19 모터 동작 완료
2026-10-20 day05: TIM4 엔코더 모드, CPR 3840 측정, 듀티-RPM 표
2026-10-21 day6: PI 속도 제어(TIM2 ISR), Kp 50 Ki 300, 스텝 응답 측정
2026-11-07 day07: INA 219전류 측정, I2C 자동 복구, LCD 상태 표시, 제어 루프 지터 비교
2026-11-08 day08: CAN 루프백(500kbps) + 소형 보드 SWD 업로드, LED(PB12)
2026-11-09 day09: 2노드 CAN(0x100/0x200), E2E 체크섬·alive, 100ms 타임아웃 안전 상태
2026-11-10 day10: IWDG, 과전류/엔코더 고장 감지, FI-01~07 고장 주입 시험, 요구사항/시험 보고서/readme까지 작성 완료
2026-11-10 Readme.md 수정
2026-11-10 README 수정
2026-11-11 docs: 측정값 문서 정리
