codingSkeleton6478/stm32-motor-ecu/(notices)

Notices in the files:
nucleo_motor_ecu/Core/Src/main.c:
Copyright (c) 2026 STMicroelectronics.
All rights reserved.
This software is licensed under terms that can be found in the LICENSE file
